Danacruzrui/Rowing_Machine/InterfazWeb/data/concept2.jpg

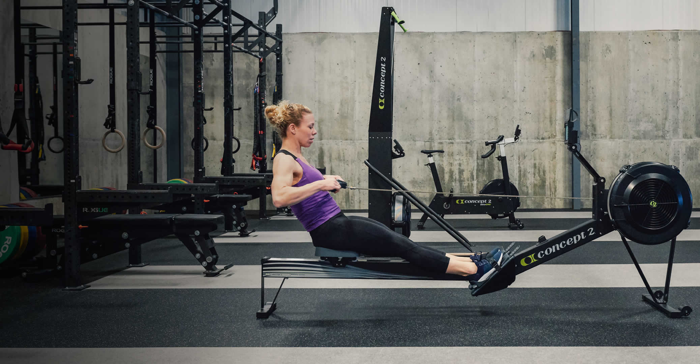
InterfazWeb/data/concept2.jpg
